burakaltingoz/Arduino-drawing-robot-cnc/pic.jpg

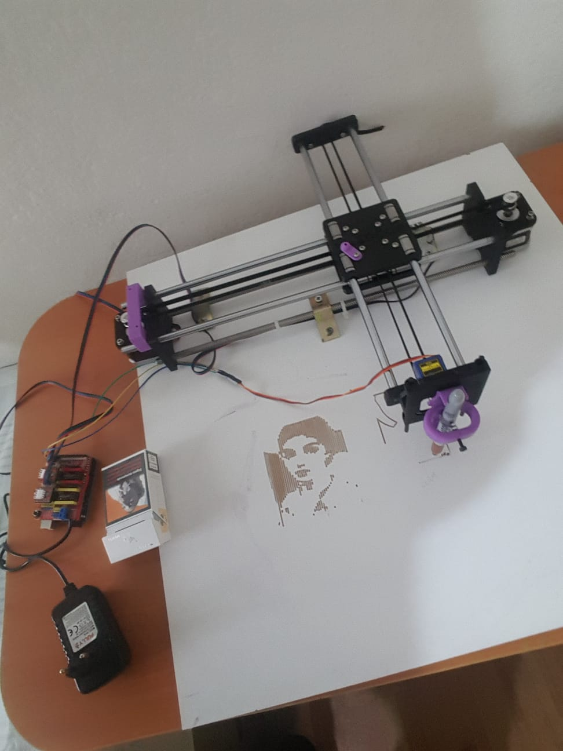
pic.jpg
