burakaltingoz/Arduino-drawing-robot-cnc/robotreport.rtf

X-Y ÇİZİM ROBOTU PROJE RAPORU

ROBOT TECHNOLOGİES

BURAK ALTINGÖZ

2012010217055

BİLGİSAYAR MÜHENDİSLİĞİ %100 II. ÖĞRETİM

1.İÇİNDEKİLER

SAYFA

GİRİŞ 2

ÖZET 3

PROJENİN DONANIMSAL YAPIM AŞAMASI 4

a. Gereken Malzemeler 4

b. 3 boyutlu yazıcı parçalarının monte edilmesi 5

c. Elektronik ve Kabloların Montajı 7

d. Motor sürücülerinin referans gerilimi 9

PROJENİN YAZILIMSAL YAPIM AŞAMASI 9

a.Arduino kodunu yükleme 9

b.Görüntüyü matlab programıyla işleme 10

c.İşlenilen görünütüye gcode oluşturulması 16

d.Robotun Universal Gcode Sender programı 18

e.Çizim Aşaması 20

KATKIDA BULUNANLAR 21

2. GİRİŞ

X-Y çizim robotu projemizde işlenilen bir görüntünün arduino kullanılarak otomatik bir şekilde kağıda çizilmesi amaçlanmıştır. Bu projenin seçilme amacı cnc lazer makinalarının çalışma prensibini tam anlamıyla öğrenebilmek ve ortaya eğlenceli bir iş çıkarabilmektir. Ayrıca X-Y çizim robotu projesiyle geleceğin teknolojisi olan 3 boyutlu yazıcıların dünyasına 2 boyuttan bir giriş yaparak inovasyona ayak uydurulmuştur.

2

3.ÖZET

X-Y çizim robotu projesinde arduino ile CNC makinasına benzer bir proje yapılmıştır. Çizilecek görüntü kameradan alınıp Matlab derleyicisi ile işlenmiştir ve binary bir görüntüye çevrilip tersi alınmıştır. Ardından görüntü Inkscape uygulamasına atılıp piksel sayısı, uzunluk, genişlik gibi durumları ayarlanıp gcode uzantılı bir dosyaya dönüştürülmüştür. Universal Gcode Sender java uygulaması ile arduinoya bağlanılıp, önceden yaptığımız gcode uzantılı dosyamız arduinonun içine atılmıştır. İki adet step motor, bir adet servo motor ile oluşturduğumuz robot sayesinde başta çekilen görüntünün son hali A4 kağıdına çizilmiştir.

Güç kaynağı 12 volt ve 10 amperlik çelik kasalı bir güç kaynağından çekilmiştir. Ancak 10 amper bu çizim robotu için fazladır. Devre ihtiyacı kadar amper çeker ama yine de bu önerilmez. Güç kaynağı için 6 amper yeterli olacaktır. Robot tarafından çizilen görüntü binary olduğu için Sharpie marka kalem çizim için daha iyidir.

Bu X-Y çizim robotu projesi lazer kesme makinası olarak kullanılabilir veya x ve y ekseninin yanına z ekseni eklendiğinde 3 boyutlu yazıcıya çevrilebilir. Bunlar yapılacak olan projenin artı yönleridir.

Projenin eksi yönlerinin en büyüğü denge sorunudur. Y ekseninin ucuna takılan kalem tutacağı dengeyi bozar. Y ekseninin artı ve eksi yönü eşitken sorun yoktur ama eksi yöndeki pay çoğaldıkça denge sorunu artar. Merkeze ağırlık koyarak sorun çözülebilr. Bir diğer eksi yönü rulmanların içinde hareket eden çubuklara dokunursak yarattığı statik elektriklenmeyi elimize alabiliriz ve develerin açık olması sebebiyle cnc shielde en ufak bir dokunuşta devreleri yakabiliriz. Antistatik bileklik kullanılması önerilir.

3

4. PROJENİN DONANIMSAL YAPIM AŞAMASI

a. Gereken Malzemeler

2 adet Nema 17 step motor 17HS4401

8 adet LM8UU rulman

2 adet 8 mm çaplı 400 mm uzunluğunda krom kaplı bar

2 adet 8 mm çaplu 350 mm uzunluğunda krom kaplı bar

2 adet 5 mm*16 diş kasnak

10 adet 623zz rulman

1 adet SG90 mikro servo motor

1 adet arduino uno R3

1 adet arduino için cnc shield

2 adet A4988 step motor sürücü

1 adet 2 metre boyunda kayış

2 adet 400 mm vidalı mil

8 adet M8 somun

8 adet M8 pul

9 adet M3 6 mm alyan vida

1 adet 12 v 6 amper güç kaynağı

8 adet M3 39 mm vida

12 adet M3 somun

2 adet M3 pul

6 adet M3 16 mm vida

1 adet arduino usb kablosu

20 adet dişi-erkek bağlantı kablosu

10 adet plastik kelepçe

4

4 adet M3 10 mm vida

6 adet 2 pinli adet dişi-dişi 2.54 mm konnektör

2 adet 4mm*10cm karbonfiber çubuk

1 adet sharpie kalem

3 boyutlu yazıcıdan çıkarılacak parçalar

b. 3 boyutlu yazıcı parçalarının monte edilmesi

Yazıcıdan çıkan parçaların hepsi aşağıdaki gibidir. Hepsi monte ederken kolaylık olsun diye numaralandırılmıştır.

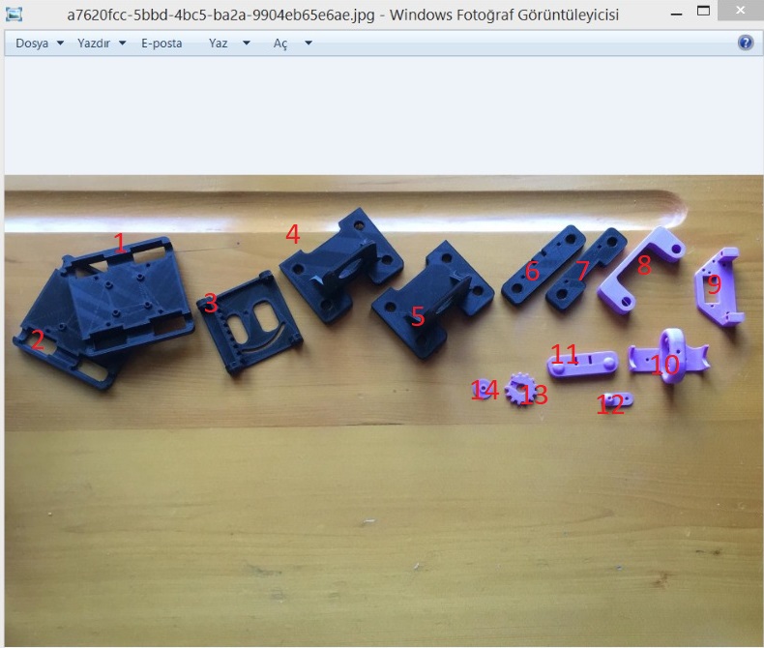
[picture p2: figure]

İlk olarak 400 mm uzunluğundaki aliminyum barlarımıza 2 şer adet olacak şekilde LM8UU rulmanlarımızı geçiriyoruz. Ardından 4 ve 5 numaralı malzemelerimize çıkıntıları, dış tarafta ve yere uzak kalacak şekilde üst taraflara sokuyoruz. Ardından aynı numaralı parçaların alt tarafında kalan deliklerin içine vidalı millerimizi sokup monte diyoruz. 1 numaralı malzememize üst tarafından 4 adet m3 vida geçirip, alttan çıkan vidalara 623zz rulmanlarımızı her vidaya ikişer adet olacak şekilde takıyoruz ve rulman gözlerine LM8UU rulmanlarını geçiriyoruz. 2 numaralı parçamızı kurduğumuz düzenekte alt taraftan ilk taktığımız LM8UU rulmanlarına monte edip, üst taraftan da kurduğumuz bir numaralı

5

düzeneği birbirine geçiriyoruz. Ardından denge kaybı olmasın diye 4 vidayı her birini yarım tur olacak şekilde sıra sıra sıkıyoruz. Üstte boş kalan LM8UU rulmanlarına 350 mm uzunluğundaki aliminyum

barlarımızı sokuyoruz. Bu 350 mm uzunluğundaki barların uçlarına 6 ve 7 numaralı malzemelerimizi sokuyoruz. 4 ve 5 numaralı malzemelere step motorların uçları deliklerden geçecek şekilde takıp alyan vidalarıyla sabitliyoruz. Step motorlarımızın uçlarına dişli kasnaklarımızı monte ediyoruz. 7 numaralı parçamıza üstten vida sokarak aşağı tarafına kalan 623 zz rulmanımızı monte ediyoruz. Çoğunluğu biten montajımıza kemeri takmak için aşağıdaki yolu izleyin.

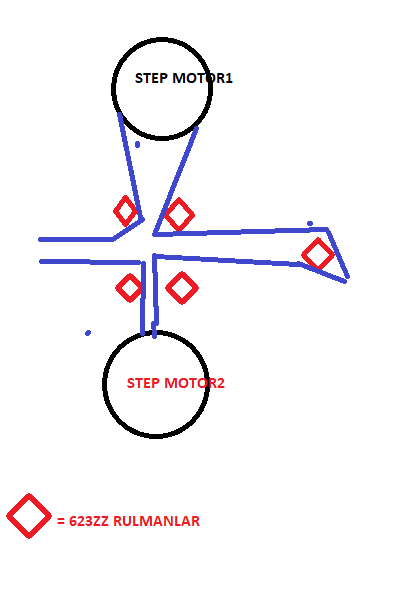
[picture p3: figure]

Kemerin boşta kalan 2 ucunu 6 numaralı malzemelerin deliklerinden ve 11 numaralı malzemenin deliklerinden geçirerek plastiktik kelepçe yardımıyla iyice gerip mühürleyin ve 11 numaralı malzemeyi 6 numaralı malzemeye vidalayın. 10 numaralı malzememiz olan kalem tutacağını 3 numaralı gülen surat malzemesinin ön tarafına monte edin. Ardından 9 numaralı malzemenin içi boş tarafı yukarda olacak şekilde 7 numaralı parçaya vidayla monte ediyoruz.

6

Ardından SG90 mikro servo motorumuzu 8 numaralı parçanın deliğinden sokup oraya oturtuyoruz ve motorun ucuna 13 numaralı çarkı takıyoruz. 3 numaralı malzememizi dişlerinin çarkın dişleriyle oturacak şekilde 9 numaralı parçaya monte ediyoruz. Son olarak 12 numaralı parçamızı kablolar düzenli dursun diye 1 numaralı parçamızın üstündeki vidalardan birine monte edip içinden plastik kelepçe geçiriyoruz. 8 numaralı parçamızı 4 numaralı parçamızdan çıkan aliminyum barlara geçiriyoruz ve montaj işlemimizi bitiriyoruz.

c. Elektronik ve Kabloların Montajı

İlk olarak cnc shieldımıza kablo leyimlemememiz gerekmektedir. Kablonun bir ucunu aşağıda gösterilen direk 12 volt gerilim çekeceği yere leyimleyiniz.

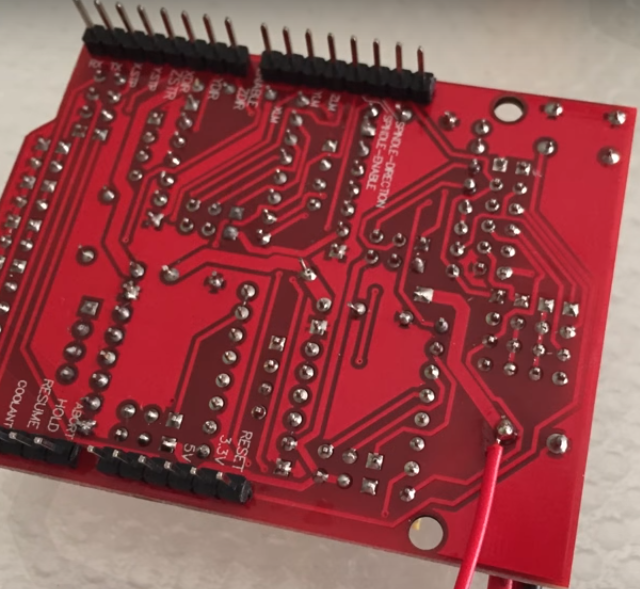
[picture p4: figure]

Ardından arudionoyu ters çevirip kablonun diğer ucunu VIN arduino kalemine aşağıdaki resimde görüldüğü gibi leyimleyiniz.

7

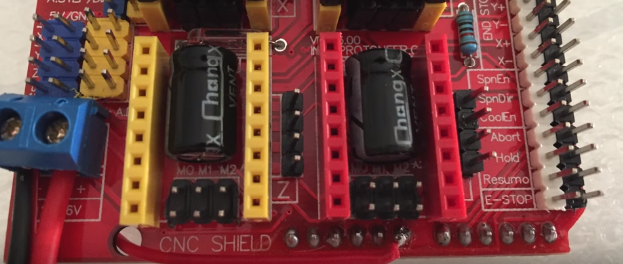
[picture p5: figure]

Adaptörün iki ucunu cnc shieldın pozitif ve negatif yönlerine bağlayınız. 2.54 mm konnektörleri A4988 motor driverları takacağımız yuvaların altında kalan pinlere toplam 6 adet olmak üzere yerleştiriniz. Motor driverlarını yuvalarına yerleştiriniz. Motorların kablolarını aşağıdaki resimde gördüğümüz gibi takıyoruz.

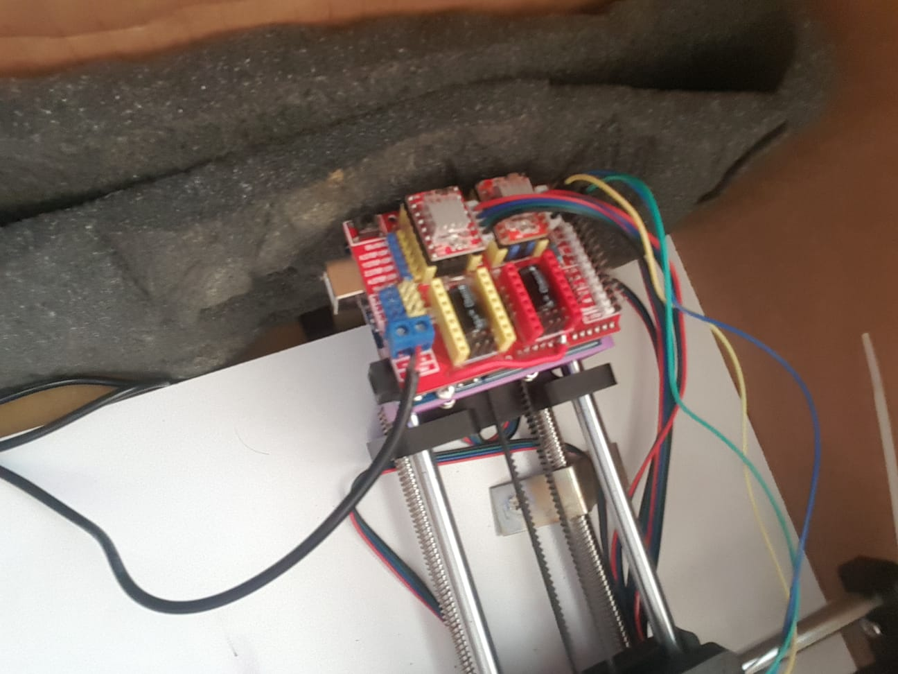
[picture p6: figure]

8

Servo motorun kablolarının artı ve eksi yönleri 5 voltluk gerilime, sinyal kablosunu da end stops Z+ pinine takıyoruz. Step motor kablolarını A4988 sürücülerinin yanına resimde görüldüğü gibi takıyoruz. Step motor kablolarını ters takmanız halinde ayna çizim gibi sorunlarla karşılaşabilir. Kablolarımızın bağlanması adımını bitiriyoruz.

d. Motor sürücülerinin referans gerilimi değerlerinin ayarlanması

Bu adımda motor sürücüsün üstündeki vidayı çevirerek referans gerilimin bulmaya çalışacağız. Referans gerliminin formülü aşağıdaki gibidir.

Vref= Imax *(8*Rs)*0,7

Imax: Bu değeri step motorumuzun türünden öğrenebiliriz. Bizim step motorumuz 17HS olduğu için Imax değerimiz 1,7 olur.

Rs: bu direnç motor A4988 sürücümüzün üstünde yazan R değerine göre belirlenir. Çok küçük yazdığı için mercek veya telefon kamerasıyla bakmak önerilir. Bizim sürücümüzün üstünde R100 yazdığı için Rs değerini 0,1 olarak alıyoruz.

0,7: Bu değer yüzde 70 performansla kullanacağımız için seçildi.

Son formülümüz aşağıdaki gibidir.

Vref= 1.7*(8*0.1)*0,7

Referans gerilimimiz Vref burdan 0,952 volt çıkmıştır.

Şimdi bir voltmetre yardımıyla motor driverımızın vidasını çevirebileceğimiz bir tornavidaya siyah timsah ucu, usb girişine takılmış cnc shieldımızın adaptörünü çıkardığımız artı ucuna da kırmızı ucu takıyoruz. Ardından dc gerilimini seçerek vidayı sapa sola çevirip 0,952 volt olan referans gerilimini buluyoruz. Bu ayarlamayı her iki sürücü için de ayrı ayrı yapmak zorundayız.

5.PROJENİN YAZILIMSAL YAPIM AŞAMASI

a.Arduino kodunu yükleme

Bilgisayarımıza indireceğimiz arduino programına grblUpload adlı kütüphaneyi eklememiz gerekmektedir. Arama motorlarından arayarak bulabileceğiniz grblUpload kütüphanesini arduino programının taslak/libary ekle/.ZIP kitaplığından ekle seçeneğinden grblUpload kütüphanesini seçerek kodu açıyoruz. Kodu derleyip usb ile arduinoya bağlıyoruz.

9

Araçlar/Kart seçeneğinde arduinomuzun türünü seçiyoruz. Ardından Araçlar/port seçeneğinden arduinomuzu seçip yükleye basıyoruz. Kodumuzu arduinoya atma işlemini bitiriyoruz.

b.Görüntüyü matlab programıyla işleme

Çizmek istediğimiz görüntüyü çizime hazır hale getirmemiz için önce binary görüntüye yada edge detection ile köşeli bir görüntüye çevirmek gerekir. İşlmek istediğiniz görüntü matlab kodunun olduğu dosyanın içinde bulunmak zorundadır. A=imread('xx.jpg')

İlk olarak orijinal görüntümüzü gri tonda bir görüntüye çeviyoruz. Ardından resmin üzerine, sigma değerini 1,4 olarak tanımladığımız gauss filtresinin bulanıklığını uyguluyoruz. Böylelikle gürültünün bir kısmını gidermiş oluyoruz. Sobel filtresi kullanarak garadyantları belirliyoruz. Gradyant büyüklüğünü ve yön açısını elde edebilmek için formül kullanıyoruz ve gradyant bir görüntü elde ederiz. Bu görüntünün kenarları çok büyüktür. Bu büyük kaenarları bastırmak için supperpression yani baskılama uyguluyoruz. 3x3 baskılamasını 8 bölüme ayırmamız gerektiği için piksel için gradyan yönü 22,5 ve -22,5 arasına düşerse karşılaştırma yapmak için kullanılır. Burda sonuç olarak çıkan resim yine çizim için uygun olmadığı için son olarak çift eşikleme kullanarak, yüksek ve düşük eşik değeri olarak belirlediğimiz pikseller eksik kenarları tamamlar veya düşük eşik değerinin altındaysa yok olur.

Filtrelenmiş görüntü matlab kodu

function cannyedgedet ()

close all; % hepsini kapatma

sigma = 1.4; % Gaussian filter sigma

highThresholdRatio = 0.2; % en yüksek eşik oranı

lowThresholdRatio = 0.15; % en düşük eşik oranı

% geçerli dosyayı m uzantılı file yapmak için. çok gerek yok

if(~isdeployed)

cd(fileparts(which(mfilename)));

end

10

im = imread('testimage.png');

figure; imshow(im);

title('Original Image');

% 5x5 gaus filtresiyle görüntüyü yumuşat

im = rgb2gray(im);

im = double(imgaussfilt(im,sigma));

% Resmin yoğunluk derecesini bulun

Gx = SobelFilter(im, 'x');

Gy = SobelFilter(im, 'y');

Gx = imgaussfilt(Gx,sigma);

Gy = imgaussfilt(Gy,sigma);

% gradientın büyüklüğünü bul

Gmag = sqrt(Gx.^2 + Gy.^2);

angle = atan2(Gy,Gx)*180/pi;

% değişim olmadan max değişim gerçekleştirir

[h,w] = size(im);

X=[-1,0,+1 ;-1,0,+1 ;-1,0,+1];

11

Y=[-1,-1,-1 ;0,0,0 ;+1,+1,+1];

output = zeros(h,w);

x = [0 1];

for i=2:h-1 % row

for j=2:w-1 % col

if (angle(i,j)>=-22.5 && angle(i,j)<=22.5) || ...

(angle(i,j)<-157.5 && angle(i,j)>=-180)

if (Gmag(i,j) >= Gmag(i,j+1)) && ...

(Gmag(i,j) >= Gmag(i,j-1))

output(i,j)= Gmag(i,j);

else

output(i,j)=0;

end

elseif (angle(i,j)>=22.5 && angle(i,j)<=67.5) || ...

(angle(i,j)<-112.5 && angle(i,j)>=-157.5)

if (Gmag(i,j) >= Gmag(i+1,j+1)) && ...

(Gmag(i,j) >= Gmag(i-1,j-1))

output(i,j)= Gmag(i,j);

else

output(i,j)=0;

end

elseif (angle(i,j)>=67.5 && angle(i,j)<=112.5) || ...

(angle(i,j)<-67.5 && angle(i,j)>=-112.5)

if (Gmag(i,j) >= Gmag(i+1,j)) && ...

(Gmag(i,j) >= Gmag(i-1,j))

output(i,j)= Gmag(i,j);

else

output(i,j)=0;

end

elseif (angle(i,j)>=112.5 && angle(i,j)<=157.5) || ...

12

(angle(i,j)<-22.5 && angle(i,j)>=-67.5)

if (Gmag(i,j) >= Gmag(i+1,j-1)) && ...

(Gmag(i,j) >= Gmag(i-1,j+1))

output(i,j)= Gmag(i,j);

else

output(i,j)=0;

end

end

end

end

Gmag = NormalizeMatrix(output);

% thresholding yapar

highThreshold = max(max(Gmag))*highThresholdRatio;

lowThreshold = highThreshold*lowThresholdRatio;

strongEdgesRow = zeros(1,h); % satırdaki en güçlü kenarı takip etme

strongEdgesCol = zeros(1,w); % sütundaki en güçlü kenarı takip etme

weakEdgesRow = zeros(1,h); % satırdaki en zayıf kenarı takip etme

weakEdgesCol = zeros(1,w); % sütundaki en zayıf kenarı takip etme

strongIndex = 1;

weakIndex = 1;

for i=2:h-1 % row

for j=2:w-1 % col

if Gmag(i,j) > highThreshold % güçlü kenar

Gmag(i,j) = 1;

strongEdgesRow(strongIndex) = i;

strongEdgesCol(strongIndex) = j;

13

strongIndex = strongIndex + 1;

elseif Gmag(i,j) < lowThreshold % kenar yok

Gmag(i,j) = 0;

else % zayıf kenar

weakEdgesRow(weakIndex) = i;

weakEdgesCol(weakIndex) = j;

weakIndex = weakIndex + 1;

end

end

end

% Perform edge tracking by hysteresis

set(0,'RecursionLimit',10000)

for i=1:strongIndex-1

% Güclü kenarlara bağlı ve ayarlanmış zayıf kenarları bulur

% ve 1 yapar

Gmag = FindConnectedWeakEdges(Gmag, strongEdgesRow(i),...

strongEdgesCol(i));

end

% zayıf kenarları çıkarma ve yerine gürültü koyma

for i=1:weakIndex-1

if Gmag(weakEdgesRow(i),weakEdgesCol(i)) ~= 1

Gmag(weakEdgesRow(i),weakEdgesCol(i)) = 0;

end

end

14

figure; imshow(Gmag);

end

% Normalize matrix

function[A] = NormalizeMatrix(A)

A = A/max(A(:));

end

% sobel filtresi uygulaması

function[A] = SobelFilter(A, filterDirection)

switch filterDirection

case 'x'

Gx = [-1 0 +1; -2 0 +2; -1 0 +1];

A = imfilter(A, double(Gx), 'conv', 'replicate');

case 'y'

Gy = [-1 -2 -1; 0 0 0; +1 +2 +1];

A = imfilter(A, double(Gy), 'conv', 'replicate');

otherwise

error('Yanlis filtre girisi - ''x'' veya ''y''');

end

end

% yüksek değerleri kenarlara bağlı olan düşük değerli kenarları bağlar

function[Gmag] = FindConnectedWeakEdges(Gmag, row, col)

for i = -2:1:2

for j = -2:1:2

if (row+i > 0) && (col+j > 0) && (row+i < size(Gmag,1)) && ...

15

(col+j < size(Gmag,2)) % resmin sınırlarının dışına filtre atmıyor

if (Gmag(row+i,col+j) > 0) && (Gmag(row+i,col+j) < 1)

Gmag(row+i,col+j) = 1;

Gmag = FindConnectedWeakEdges(Gmag, row+i, col+j);

end

end

end

end

end

c. İşlenilen görünütüye gcode oluşturulması

Görüntüye gcode oluşturmak için Inkscape adlı programı kullanmamız gerekir. Bu programda gcode oluşturabilmek için ise TurnKeyLaser plugini gerekmektedir. Arama motorlarından bularak indireceğimiz TurnKeyLaser dosyasının içinde bulunan turnkeylaser.py ver turnkeylaser.inx dosyalarını Inkscape programının dosya konumunun bulunduğu yere kopyalayarak pluginimizi programa entegre ediyoruz.

Ardından Inkscape programını açıyoruz. Dosya/Belge Seçenekleri tıklayarak çizdirmek istediğimiz resmin sayfa büyüklüğünü milimetre olarak belirliyoruz. X-Y çizim robotumuzun gövde büyüklüğüne göre çizeceği maksimum boyut 280 milimetre genişlik ve 350 milimetre yüksekliktir. Çizim süresini kısaltmak için 200 mm genişlik ve 200 mm yükseklik seçiyoruz ardından bu mm seçeneğini piksele çeviriyoruz.

16

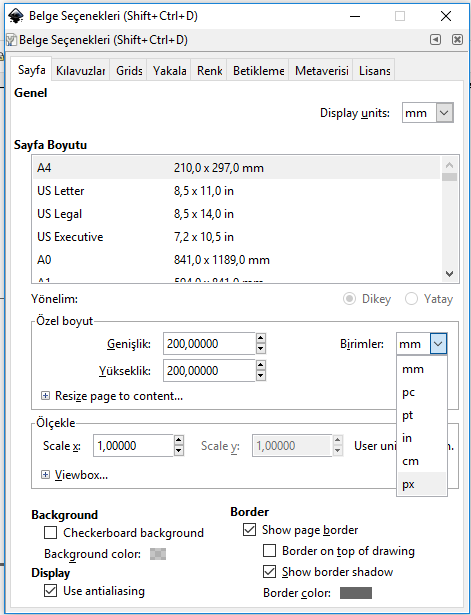
[picture p7: figure]

Dosya/İçeri Aktar seçeneğine tıklayarak çizilecek resmi açıyoruz. Belirlenen resmin kağıt üzerinde ne kadar yer kaplayacağını belirliyoruz. Yol/Resmi vektörize et diyerek tamama basıyoruz ve resmin üstünden yeni resmi sürüklüyoruz. Ardından eski resmi silip yenisi üzerinde işlem yapmaya başlıyoruz. Nesne/Doldur ve Çiz seçeneğine basarak dolgu seçeneğini boş bırakıyoruz ardından kenarlık rengi seçeneğini düz renk yapıp resmin kenarlarını belirliyoruz. Eklentiler/Axidraw/Hatch Fill seçeneğinden çizilecek resmin derinliği, kalitesi, çizgi çekilecekse çekilecek çizginin açısını belirliyoruz. Önerilen ayarlar aşağıdaki gibidir.

17

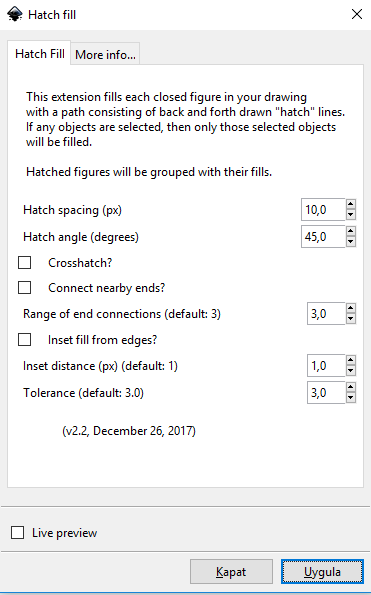
[picture p8: figure]

Son olarak Eklentiler/Dışarı Aktar/TurnKeyLaser Exporter seçeneğine basarak Home X and Y after seçeneğini işaretliyoruz. Bunun sebebi robotun çizimi bitirdikten sonra tekrar çizime başlanılan noktaya dönmesini sağlamaktır. Ardından uygulamaya basarak masaüstümüzde çizilecek olan resmin bir gcode uzantısını oluşturmuş oluyoruz.

d. Robotun Universal Gcode Sender programı ile yönlendirilmesi

Arama motoru kullanarak indirebileceğimiz universal gcode sender 1.0.9 sürümünün dosyasının içindeki start-windows.bat dosyasına basarak çalıştırıyoruz. Usb kablomuzu arduinoya bağlayıp üstüne cnc shieldımızı monte ediyoruz. UGS programı arduinonun portunu görünce open seçeneğine tıklayarak açıyoruz. Baud seçeneğini 115200, firmware seçeneğini GRBL yapıyoruz. Ardından motorların hızını, oranını, hızlanmasını ayarlayabilmek için commands sekmesine $$ yazıyoruz ve bu değerlere göz atıyoruz.

18

Önerilen değerler aşağıdaki gibidir. Bu değerleri değiştirebilmek için settings seçeneğini kullanabilir veya örnek vermek gerekirse commands sekmesine $100=100 yazıp değerleri değiştirebilirsiniz.

$2=0 (step port invert mask:00000000)

$3=0 (dir port invert mask:00000000)

$4=0 (step enable invert, bool)

$5=0 (limit pins invert, bool)

$6=0 (probe pin invert, bool)

$10=3 (status report mask:00000011)

$11=0.010 (junction deviation, mm)

$12=0.002 (arc tolerance, mm)

$13=0 (report inches, bool)

$20=0 (soft limits, bool)

$21=0 (hard limits, bool)

$22=0 (homing cycle, bool)

$23=0 (homing dir invert mask:00000000)

$24=25.000 (homing feed, mm/min)

$25=500.000 (homing seek, mm/min)

$26=250 (homing debounce, msec)

$27=1.000 (homing pull-off, mm)

$100=250.000 (x, step/mm)

$101=250.000 (y, step/mm)

$102=250.000 (z, step/mm)

$110=500.000 (x max rate, mm/min)

$111=500.000 (y max rate, mm/min)

$112=500.000 (z max rate, mm/min)

19

$120=10.000 (x accel, mm/sec^2)

$121=10.000 (y accel, mm/sec^2)

$122=10.000 (z accel, mm/sec^2)

$130=200.000 (x max travel, mm)

$131=200.000 (y max travel, mm)

$132=200.000 (z max travel, mm)

File mode sekmesine gelerek Browse butonundan, oluşturduğumuz gcode dosyasını seçiyoruz ve X-Y çizim robotumuzu fişe takıyoruz.

5. Çizim Aşaması

X-Y çizim robotumuzu fişe takıyoruz. Kalemimizi kalem tutacağına kalemin kağıda dokunacağı yeri belirleyerek monte ediyoruz. Kalemimiz detaylı çizim yapılacaksa çok ince uçlu bir kalem olmalıdır yada boyama yapacaksa Sharpie marka keçeli kalemler önerilir. Ardından UGS programından robotun çizime başlayacağı noktayı elimizle belirleyerek Machine Control sekmesinden Reset Zero butonuna basıyoruz. Artık robotun başlangıç noktası belirlenmiş oldu. File Mode seçeneğinden send butonuna basarak robotumuzu çalıştırıyoruz. Estimated Time Remaining seçeneğinden çizimin kaç dakika süreceğine bakabiliriz. Artık robotumuz bitmiş oluyor. Örnek çizim aşağıdaki gibidir.

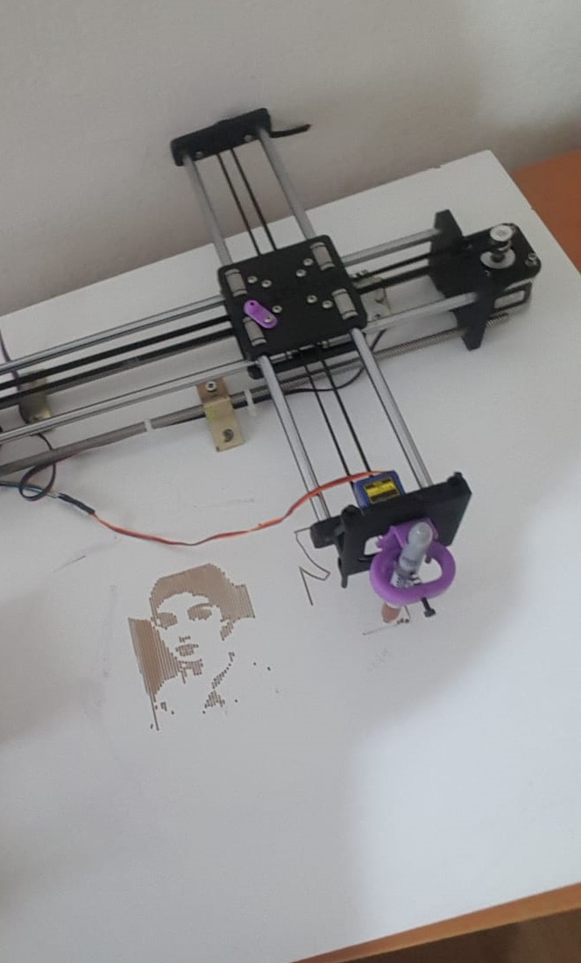
[picture p9: figure]

20

6.KATKIDA BULUNANLAR

Başta bu projeyi yapmama vesile olan Ferhat Atasoy hocama ve projenin 3 boyutlu yazıcıdan çıkması için gereken malzemelerle ilgili bana çok yardımcı olan Y3D Computer Graphics çalışanı Doğukan Türkekul Akgün’e teşekkürü borç bilirim.

21
