burakaltingoz/Arduino-drawing-robot-cnc/3d materials parts/DrawingMachine_-_PeN_CarriagE_2.stl

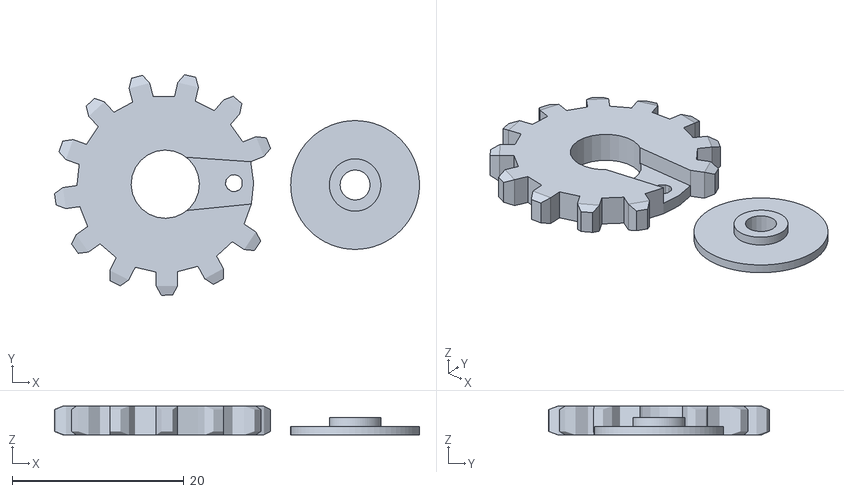
[picture p10: CAD file, 2019-07-23]
3d materials parts/DrawingMachine_-_PeN_CarriagE_2.stl
42.5 x 25.7 x 3.35
