burakaltingoz/Arduino-drawing-robot-cnc/3d materials parts/DrawingMachine_-_ServoCableHolder.stl

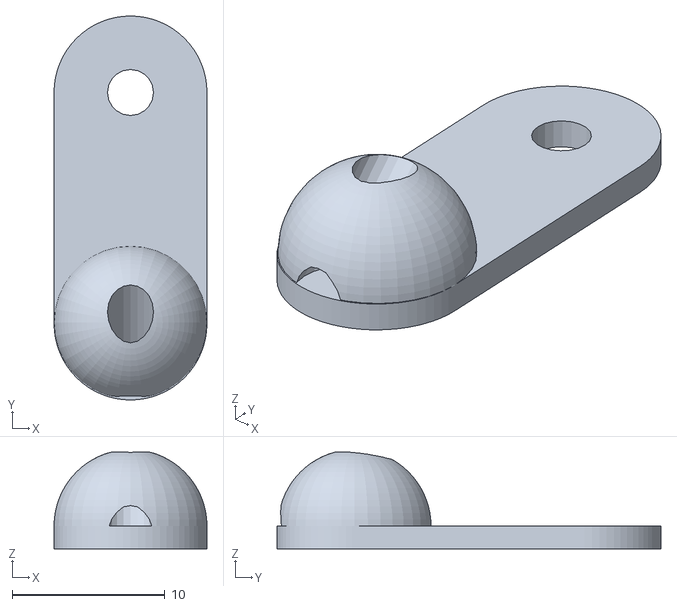
[picture p11: CAD file, 2019-07-23]
3d materials parts/DrawingMachine_-_ServoCableHolder.stl
10.0 x 25.1 x 6.34
