burakaltingoz/Arduino-drawing-robot-cnc/3d materials parts/DrawingMachine_-_ServoHolder_V2.stl

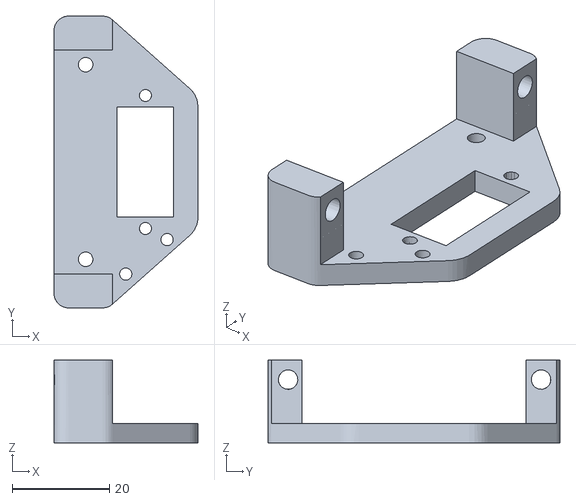
[picture p12: CAD file, 2019-07-23]
3d materials parts/DrawingMachine_-_ServoHolder_V2.stl
29.6 x 60.0 x 17.0
