burakaltingoz/Arduino-drawing-robot-cnc/3d materials parts/DrawingMachine_-_Pen_Holder-2.stl

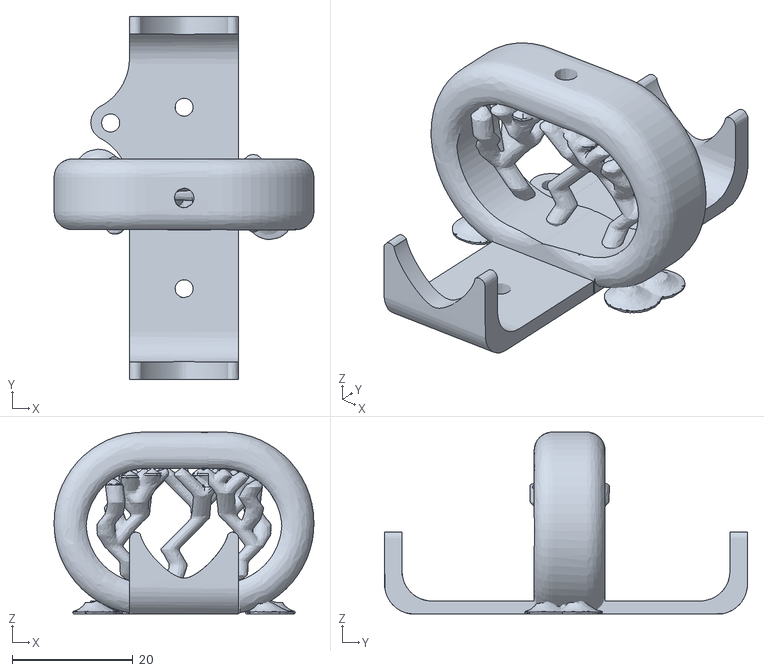
[picture p13: CAD file, 2019-07-23]
3d materials parts/DrawingMachine_-_Pen_Holder-2.stl
43.0 x 60.0 x 30.1
