burakaltingoz/Arduino-drawing-robot-cnc/3d materials parts/4xiDraw_Base_con_Dadi.stl

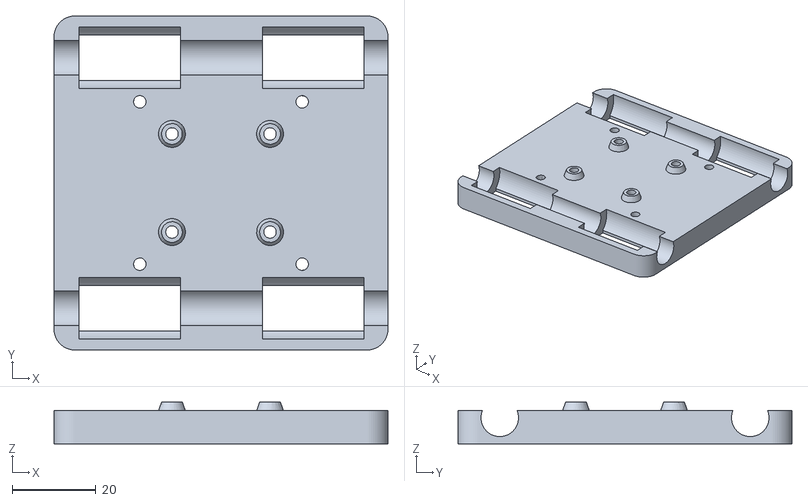
[picture p14: CAD file, 2019-07-23]
3d materials parts/4xiDraw_Base_con_Dadi.stl
80.0 x 80.0 x 10.0
