burakaltingoz/Arduino-drawing-robot-cnc/3d materials parts/DrawingMachine_-_PeN_CarriagE.stl

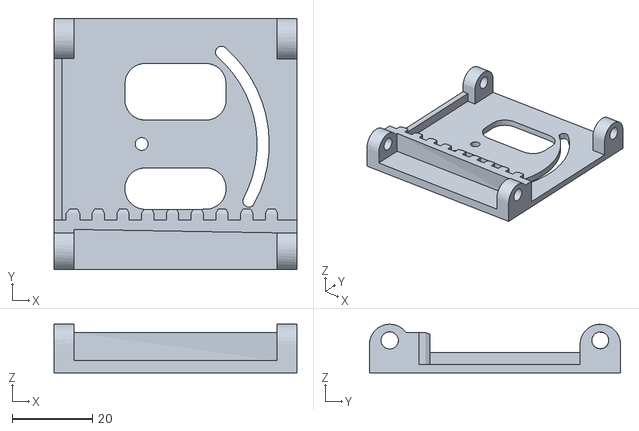
[picture p15: CAD file, 2019-07-23]
3d materials parts/DrawingMachine_-_PeN_CarriagE.stl
60.6 x 62.6 x 12.1
