burakaltingoz/Arduino-drawing-robot-cnc/3d materials parts/DrawingMachine_-_ALL_PIECES_200x200_A.stl

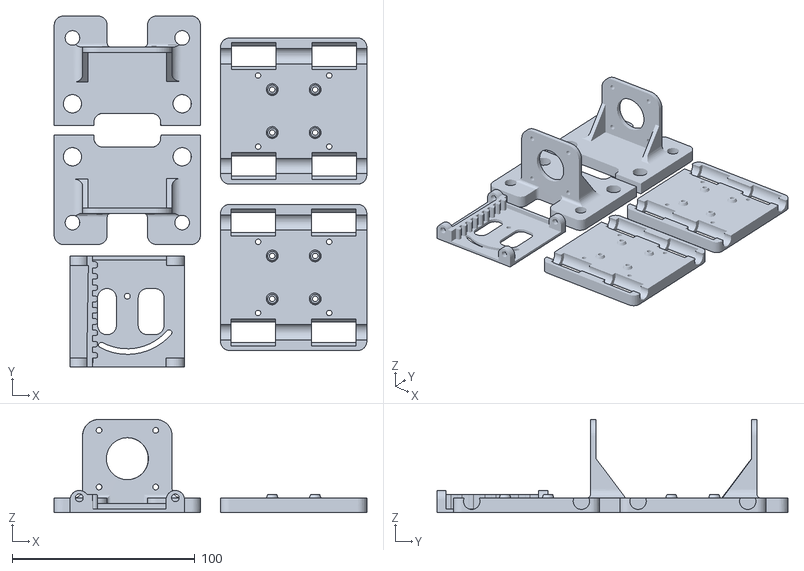
[picture p16: CAD file, 2019-07-23]
3d materials parts/DrawingMachine_-_ALL_PIECES_200x200_A.stl
171.0 x 192.0 x 51.0
