burakaltingoz/Arduino-drawing-robot-cnc/3d materials parts/DrawingMachine_-_TensoR.stl

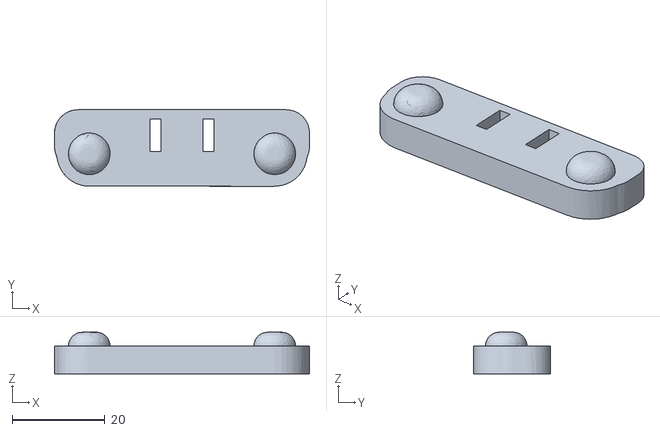
[picture p17: CAD file, 2019-07-23]
3d materials parts/DrawingMachine_-_TensoR.stl
55.0 x 16.5 x 9.00
