burakaltingoz/Arduino-drawing-robot-cnc/3d materials parts/DrawingMachine_-_ALL_PIECES_200x200_B.stl

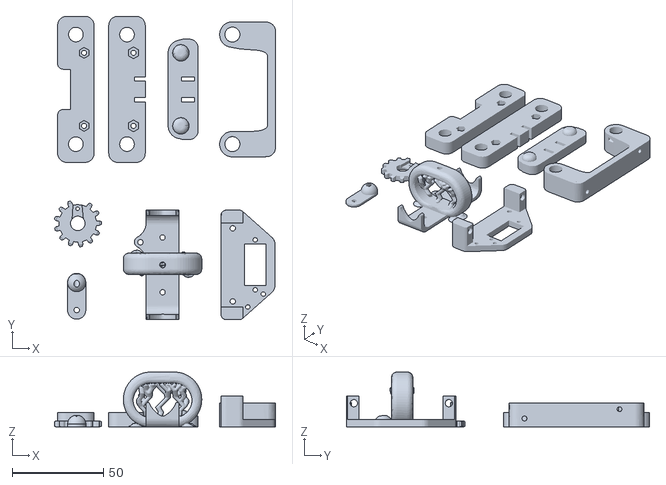
[picture p18: CAD file, 2019-07-23]
3d materials parts/DrawingMachine_-_ALL_PIECES_200x200_B.stl
121.0 x 166.1 x 30.1
