burakaltingoz/Arduino-drawing-robot-cnc/3d materials parts/DrawingMachine_-_EndY2.stl

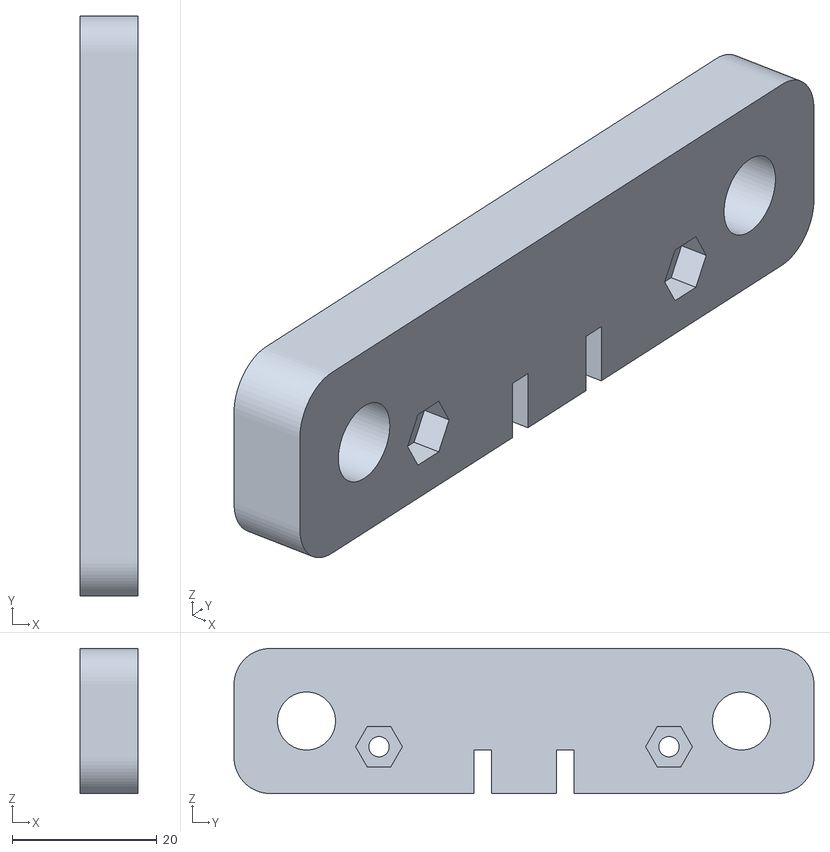
[picture p19: CAD file, 2019-07-23]
3d materials parts/DrawingMachine_-_EndY2.stl
8.00 x 80.0 x 20.0
