burakaltingoz/Arduino-drawing-robot-cnc/3d materials parts/DrawingMachine_-_newEndX_1.stl

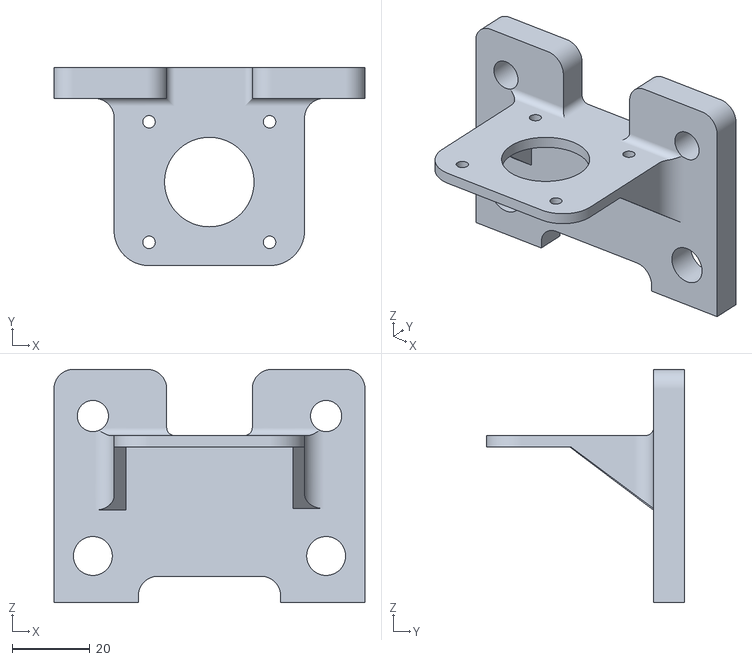
[picture p20: CAD file, 2019-07-23]
3d materials parts/DrawingMachine_-_newEndX_1.stl
80.0 x 51.0 x 60.0
