burakaltingoz/Arduino-drawing-robot-cnc/3d materials parts/DrawingMachine_-_Arduino_grip_V2.stl

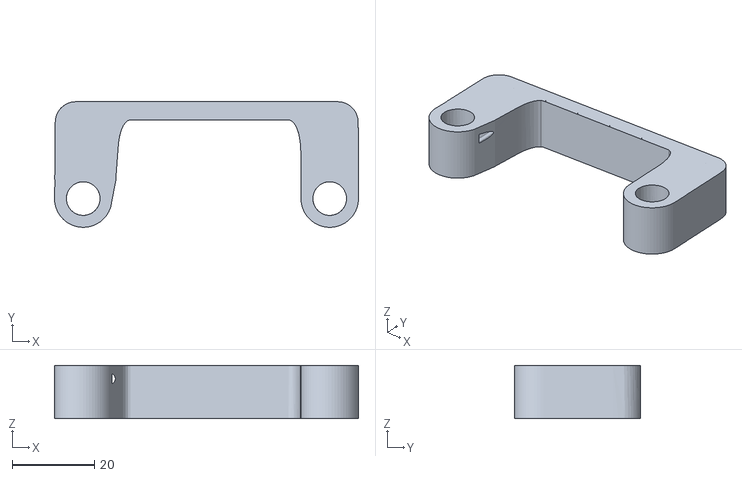
[picture p21: CAD file, 2019-07-23]
3d materials parts/DrawingMachine_-_Arduino_grip_V2.stl
74.0 x 30.6 x 13.0
