burakaltingoz/Arduino-drawing-robot-cnc/(list of files, cad)

Other CAD files:
3d materials parts/4xiDraw_Base.stl
3d materials parts/DrawingMachine_-_EndY_2.stl
